kevin-cgc/HapticGlove/hw/HapticGlovePCBv1_case-Body.3mf

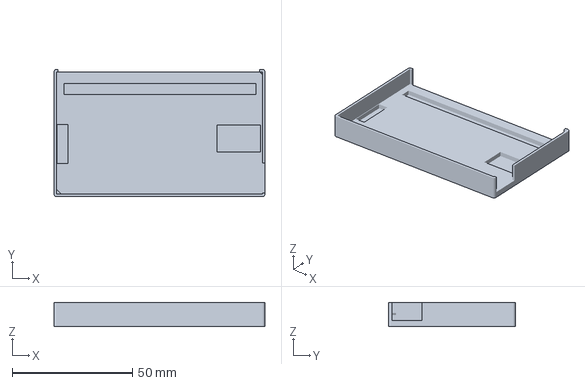
[picture p2: CAD file, 2025-01-07]
hw/HapticGlovePCBv1_case-Body.3mf
87.6 x 52.8 x 10.0 mm
