kevin-cgc/HapticGlove/hw/HapticGlovePCBv1_case.FCStd

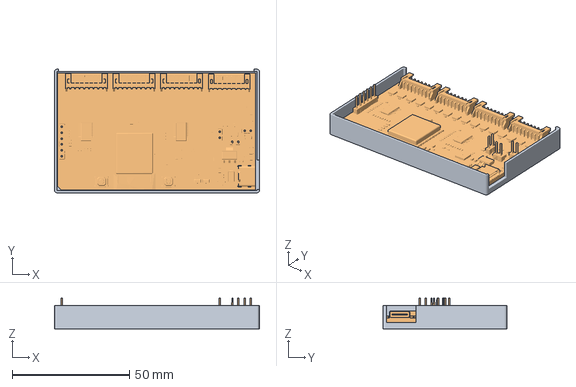
[picture p3: CAD file, 2025-01-07]
hw/HapticGlovePCBv1_case.FCStd
87.6 x 52.8 x 13.1 mm
PCB
