kevin-cgc/HapticGlove/hw/PCB_approx.stl

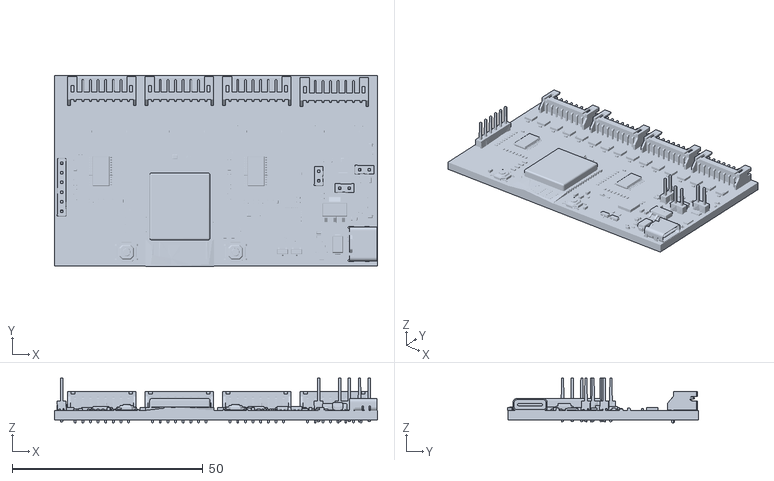
[picture p4: CAD file, 2025-01-07]
hw/PCB_approx.stl
84.7 x 50.0 x 11.8
